NOPIBOTIC/MultiSensorArduinoRaspberry/README.md

# MultiSensorArduinoRaspberry

## Arduino
B021-012-B_Multicapteur: Arduino code for MKR Zero installed on B021-012-B.

## Windows
ActiveO Control v2.0: Windows software for ActiveO board control

## 2024-04 Protocole de communication Rev2
Description of serial communication protocol
Rev2: Date, Time and Cell voltage added.

## 2024-01 Protocole de communication Rev1
Description of serial communication protocol
Rev1: First version.
