NOPIBOTIC/MultiSensorArduinoRaspberry/Carte B021-012/RevC/B021-012-C BOM.xlsx

Sheet: BOM
Bill Of Materials for ACTIV'O CONTROL
 |  |  |  |  | Prix nomenclature chez FARNELL au 14/02/2025 |  | 115.91 €
Design Title |  |  | ACTIV'O CONTROL
Author |  |  | NOPI
Document Number |  |  | B021-012
Revision |  |  | C
Design Created |  |  | jeudi 12 novembre 2020
Design Last Modified |  |  | lundi 20 janvier 2025
Total Parts In Design |  |  | 105
 |  |  |  |  |  |  |  |  |  |  | Totals
Category | Quantity | References | Value | PCB Package | Manufacturer | Manufacturer Code | Supplier | Supplier Code | Variance 1 | Variance 2 | Category | Quantity
Capacitors | 4 | C1,C4-C5,C9 | 100nF | 0805 | MULTICOMP | MC0805B104J500CT | FARNELL | 2320839 | 50V | X7R | Capacitors | 9
Capacitors | 1 | C2 | 10uF | EIA6032 | KEMET | T494C106K016AT | FARNELL | 2762191 | 16V | TAN | Resistors | 28
Capacitors | 1 | C3 | 1uF | 0805 | KEMET | C0805C105K9RACTU | FARNELL | 2905206 | 6.3V | X7R | Integrated Circuits | 7
Capacitors | 1 | C6 | 1nF | 0805 | KEMET | MC0805B102J500CT | FARNELL | 2320837 | 50V | X7R | Transistors | 6
Capacitors | 2 | C7-C8 | 1uF | 0805 | KEMET | C0805C105K4RACAUTO | FARNELL | 2070447 | 16V | X7R | Diodes | 20
Resistors | 2 | R1,R3 | 4k7 | 0805 | MULTICOMP | MCMR08X4701FTL | FARNELL | 2073779 |  | 1% | Modules | 0
Resistors | 1 | R2 | 120R | 0805 | MULTICOMP | MCMR08X1200FTL | FARNELL | 2073624 |  | 1% | Miscellaneous | 35
Resistors | 17 | R4-R9,R13-R14,R17,R20,R22-R28 | 10k | 0805 | MULTICOMP | MCMR08X1002FTL | FARNELL | 2073607 |  | 1% | Total | 105
Resistors | 2 | R10,R21 | 1k | 0805 | MULTICOMP | MCMR08X1001FTL | FARNELL | 2073606 |  | 1%
Resistors | 3 | R11,R15,R18 | 1.65k | 0805 | MULTICOMP | MCMR08X000 PTL | FARNELL | 2073603 |  | 1%
Resistors | 3 | R12,R16,R19 | 165R | 0805 | MULTICOMP | MCWF08R1650BTL | FARNELL | 2337645 |  | 0.1%
Integrated Circuits | 1 | U1 | DS3231SN | SOIC127P1032X265-16N | MAXIM | DS3231SN | FARNELL | 2518948
Integrated Circuits | 1 | U2 | ABX00012 | ABX00012 | ARDUINO | MKR ZERO | FARNELL | 2830993
Integrated Circuits | 1 | U3 | SN65HVD1781QDRQ1 | SOIC127P600X175-8N | Texas Instruments | SN65HVD1781QDRQ1 | FARNELL | 3121350
Integrated Circuits | 1 | U4 | TSR1-2450 | TSR-1 | TRACO | TSR1-2450 | FARNELL | 1696320
Integrated Circuits | 1 | U5 | MCP23017 | SO28W | Microchip | MCP23017-E/SO | FARNELL | 1332087
Integrated Circuits | 1 | U6 | MCP1804T-A002I_DB | SOT223-3 | Microchip | MCP1804T-A002I/DB | FARNELL | 2809954
Integrated Circuits | 1 | U7 | ACS712ELCTR-30A-T | SO8 | Allegro | ACS712ELCTR-30A-T | FARNELL | 1651975
Transistors | 4 | Q1-Q4 | SI4946CDY-T1-GE3 | SOIC127P600X175-8N | VISHAY | SI4946CDY-T1-GE3 | FARNELL | 2846626
Transistors | 2 | Q5-Q6 | BSS670S2LH6327XTSA1 | SOT23 | INFINEON | BSS670S2LH6327XTSA1 | FARNELL | 2432721
Diodes | 9 | D1-D2,D4,D6,D9,D12,D15,D17,D19 | LED_ROU | 0805_LED | KINGBRIGHT | KPTD-2012LVSURCK | FARNELL | 2846595 | 1.75V | 2mA
Diodes | 6 | D3,D5,D8,D11,D16,D18 | SS14 | DIOM5025X242N | ONSEMI | SS14 | FARNELL | 1467537 | 40V | 1A
Diodes | 5 | D7,D10,D13-D14,D20 | BZX84C3V6 | SOT23-D1 | DIODES INC | BZX84C3V6 | FARNELL | 1902466 | 3.6V
Miscellaneous | 1 | BAT1 | CR2032-2025 | BATHLD001 | HARWIN | BAT-HLD-001 | FARNELL | 4203654
Miscellaneous | 4 | J1,J13,J15,J17 | 691321300002 | SHDR2W80P0X381_1X2_871X700X940P | WURTH | 691321300002 | FARNELL | 1642006 | 300V | 10A
Miscellaneous | 12 | J2-J12,J16 | 691321300003 | SHDR3W80P0X381_1X3_1262X720X920P | WURTH | 691321300003 | FARNELL | 1642007 | 300V | 10A
Miscellaneous | 1 | J14 | 691321300004 | SHDR4W80P0X381_1X4_1643X720X920P | WURTH | 691321300004 | FARNELL | 1642008 | 300V | 10A
Miscellaneous | 5 | JP1,JP3,JP5,JP7-JP8 | JUMP1 | JUMP1 | GENERIC |  |  |  | BARRETTE 2.54mm | JUMPER SPC20479
Miscellaneous | 6 | JP2,JP4,JP6,JP9-JP11 | JUMP2 | JUMP2 | GENERIC |  |  |  | BARRETTE 2.54mm | JUMPER SPC20479
Miscellaneous | 4 | RL1-RL4 | ALQ112 | ALQ105 | PANASONIC | ALQ112 | FARNELL | 2503673
Miscellaneous | 2 | RL5-RL6 | DG20-7011-35 | DG207011351012 | Durakool | DG20-7011-35-1012 | FARNELL | 2103585

Sheet: Farnell
2320839 | 4
2762191 | 1
2905206 | 1
2320837 | 1
2070447 | 2
2073779 | 2
2073624 | 1
2073607 | 17
2073606 | 2
2073603 | 3
2337645 | 3
2518948 | 1
2830993 | 1
3121350 | 1
1696320 | 1
1332087 | 1
2809954 | 1
1651975 | 1
2846626 | 4
2432721 | 2
2846595 | 9
1467537 | 6
1902466 | 5
4203654 | 1
1642006 | 4
1642007 | 12
1642008 | 1
2503673 | 4
2103585 | 2
