NOPIBOTIC/MultiSensorArduinoRaspberry/Carte B021-012/RevC/B021-012-C Schematic.pdf

C3

R4

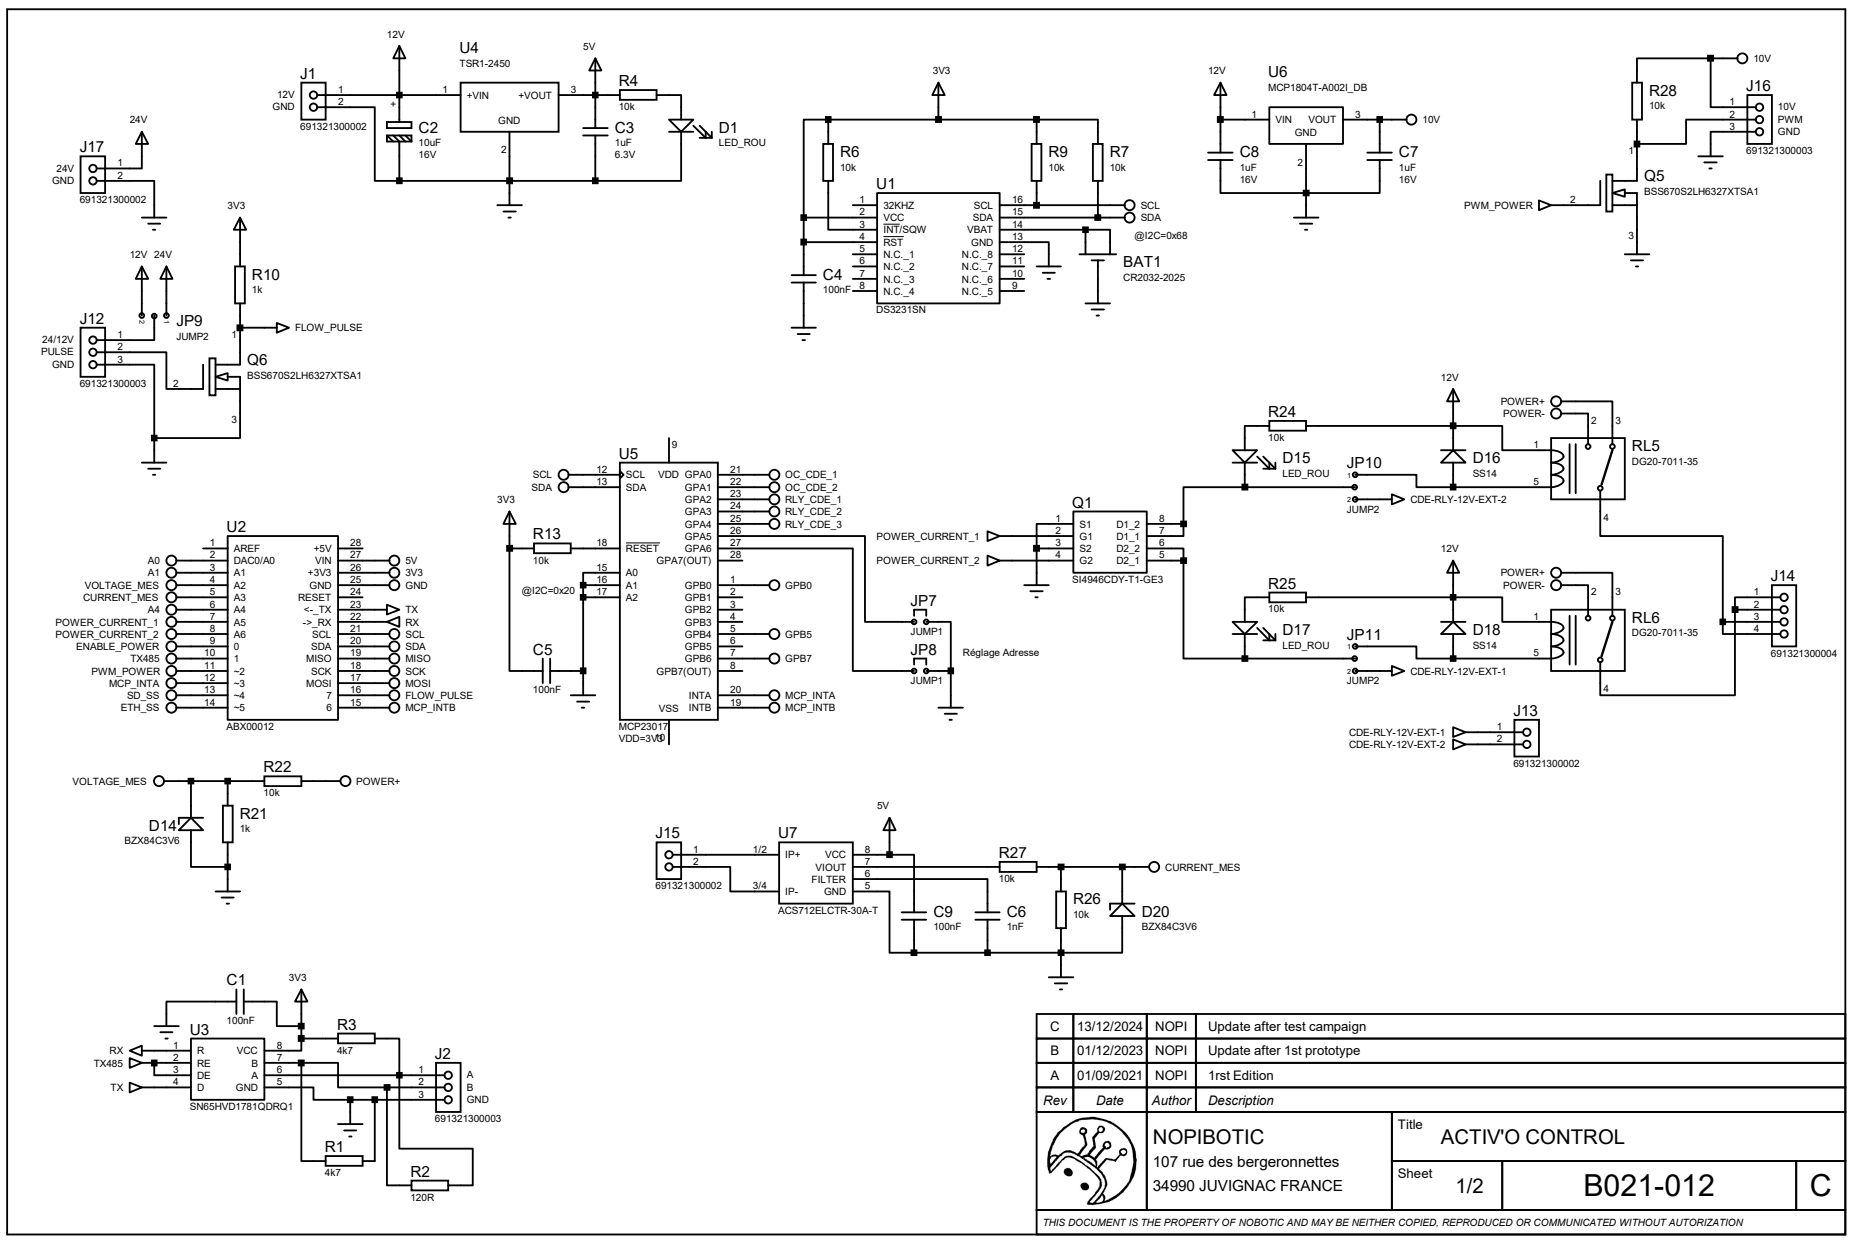
[picture p2: page 1]

THIS DOCUMENT IS THE PROPERTY OF NOBOTIC AND MAY BE NEITHER COPIED, REPRODUCED OR COMMUNICATED WITHOUT AUTORIZATION

R23

D19

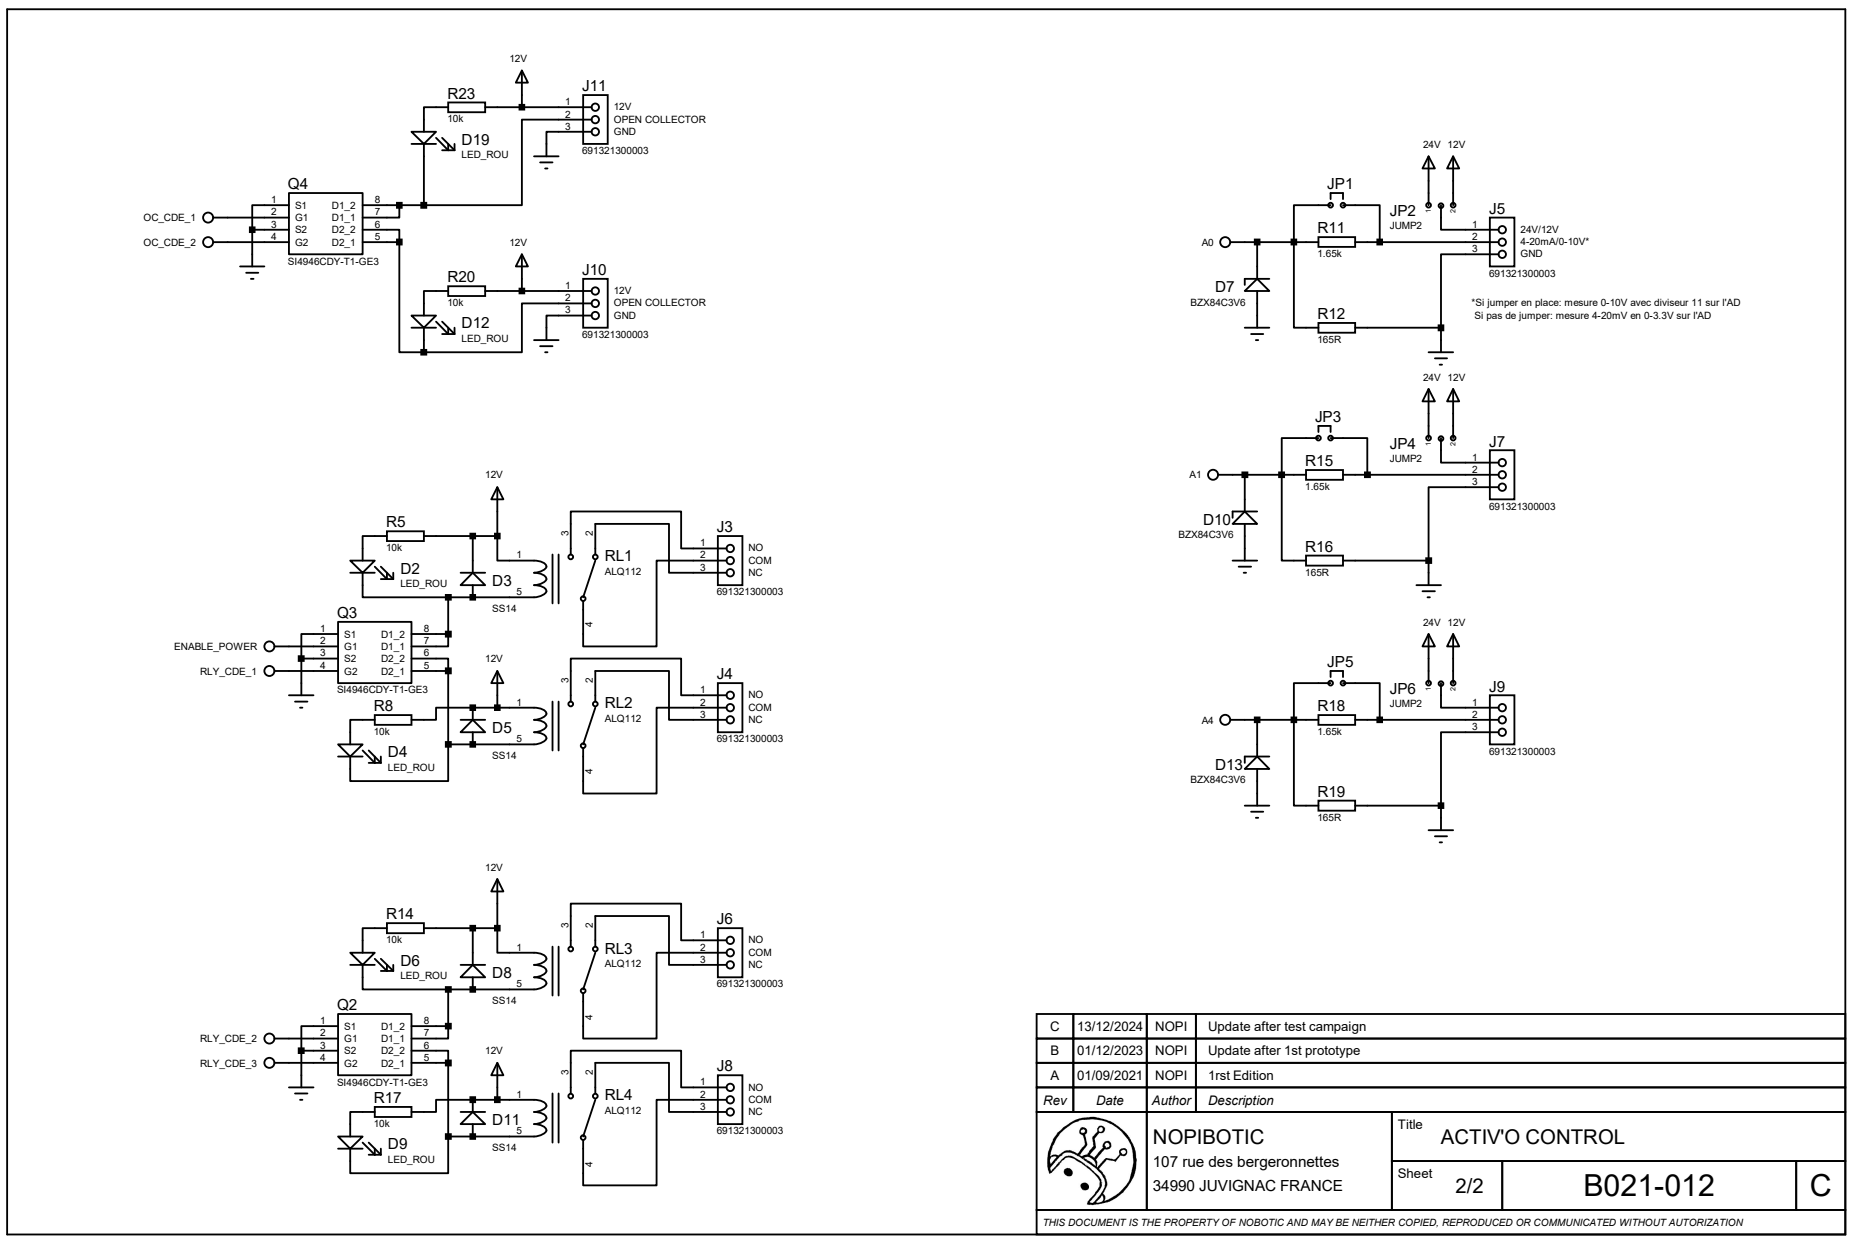
[picture p3: page 2]

*Si jumper en place: mesure 0-10V avec diviseur 11 sur l'AD
Si pas de jumper: mesure 4-20mV en 0-3.3V sur l'AD

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
