NOPIBOTIC/MultiSensorArduinoRaspberry/(list of files, drawings)

Other design files:
Carte B021-012/RevC/B021-012-C.pdsprj
