NOPIBOTIC/MultiSensorArduinoRaspberry/(commit log)

2025-05-15 Ajout des dernières versions arduino
    Ajout jusqu'à v2.4 Arduino.
    Nettoyage du dossier.
2025-05-15 Dépot des livrables définitifs ETE
    [B021-012-C BOM.xlsx, B021-012-C.pdsprj]
2026-03-04 Version 2.5 Arduino
